sandun21/instrumentation/README.md

# instrumentation
This repository is related to assignments in the module electronic instrumentation
