sandun21/instrumentation/(list of files, drawings)

Other design files:
Final Instrumentational Amplifier/PCB_Project/PCB_Project.PrjPcb
Final Instrumentational Amplifier/PCB_Project/PcbLib1.PcbLib
Final Instrumentational Amplifier/PCB_Project/sandun_final.PcbDoc
Final Instrumentational Amplifier/PCB_Project/Schlib1.SchLib
Final Instrumentational Amplifier/PCB_Project/Sheet1.SchDoc
