sandun21/instrumentation/(commit log)

2024-10-24 Selected a instrumentational amplifier and started the design
    Selected AD620 as the instrumentational amplifier IC. Initial circuit was implemented
    [Instrumentational_Amplifier.PrjPcb, PCB1.PcbDoc, PcbLib1.PcbLib, Schlib1.SchLib, Sheet1.SchDoc]
2024-10-24 Few updates
    [Instrumentational_Amplifier.PrjPcb, PCB1.PcbDoc, PcbLib1.PcbLib, Sheet1.SchDoc]
2024-10-29 finished schematics and placing components on PCB
    [Instrumentational_Amplifier.PrjPcb, PCB1.PcbDoc, Sheet1.SchDoc]
2024-10-30 started new project due to issue with constraint manager
    [Instrumentational_Amplifier.PrjPcb, PCB1.PcbDoc, PCB_Project.PrjPcb, PcbLib1.PcbLib, Schlib1.SchLib, Sheet1.SchDoc]
2024-11-02 PCB finished
    [PCB1.PcbDoc, PCB_Project.PrjPcb, Sheet1.SchDoc]
2024-11-03 reviewed by sir
    project was reviewed by sir and asked to use symmetrical input and bring amplifier closeby
    [Instrumentational_Amplifier.PrjPcb, PCB1.PcbDoc, PCB_Project.PrjPcb, PcbLib1.PcbLib, Schlib1.SchLib, Sheet1.SchDoc]
2024-11-12 exported gerber files and finalized
    [Instrumentational_Amplifier_After_revision.PrjPcb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]
2024-12-18 completed
    design documentation uploaded and deleted previous versions.
    [Instrumentational_Amplifier.PrjPcb, Instrumentational_Amplifier_After_revision.PrjPcb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]
